Ayer8315/gesture-irrigation-msp430/(list of files, drawings)

Other design files:
hardware/altium/PCB1.PcbDoc
hardware/altium/PCB_Pinar_.PrjPcb
hardware/altium/sematik.SchDoc
